ABouchi05/Lab3-AdC/results/layout/alu.png

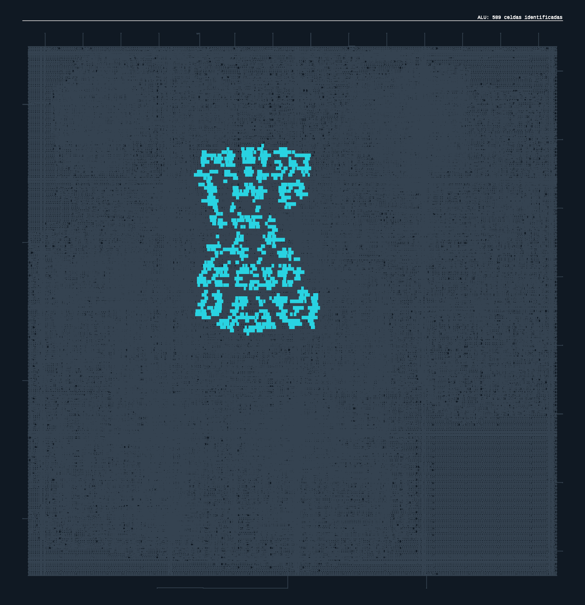
results/layout/alu.png
