ABouchi05/Lab3-AdC/results/layout/contador.png

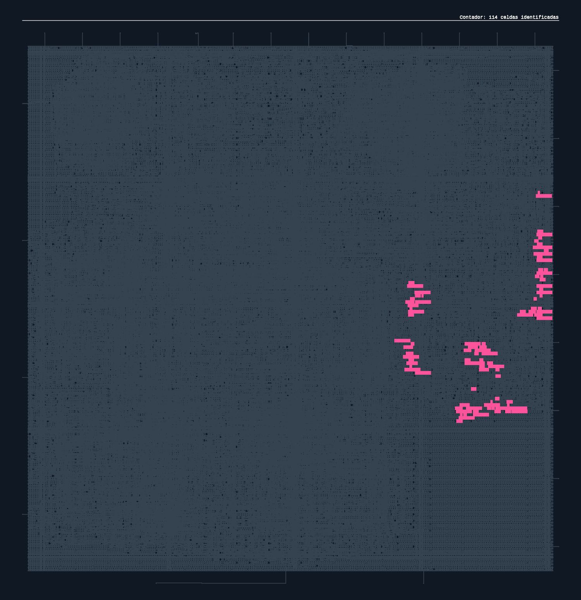
results/layout/contador.png
