ABouchi05/Lab3-AdC/results/layout/register_file.png

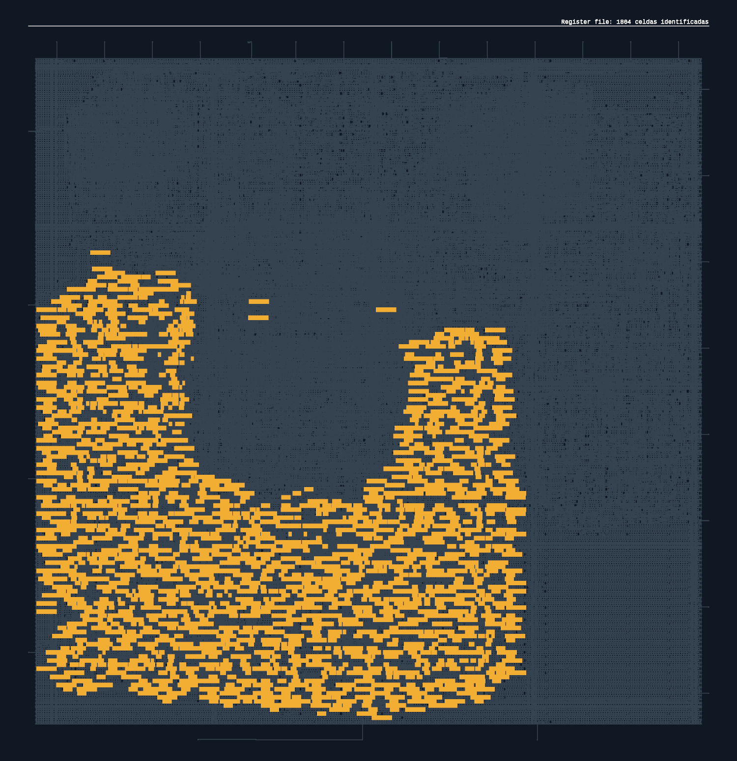
results/layout/register_file.png
