ABouchi05/Lab3-AdC/results/physical/rom_100_40/final/asic_top.png

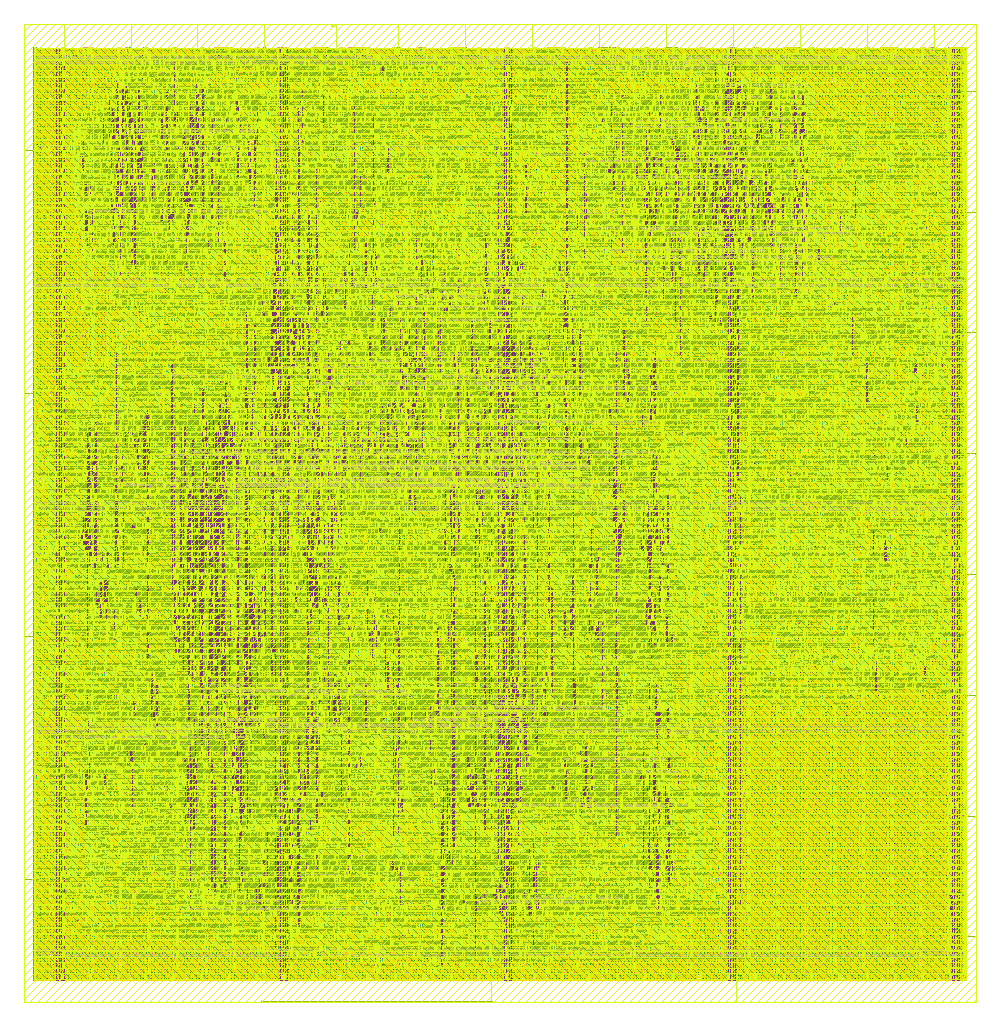
results/physical/rom_100_40/final/asic_top.png
